fflori4n/smartHive/README.md

# smartHive
smart Hive sistem - ESP32 GSM base, that collects data from multiple atmell based field sensors and sends it via mqtt
