fflori4n/smartHive/ESP_field_sensor_hub/electronics/electronics_ESP_GSM_sens_hub/RSensHub.kicad_pcb

## KiCad design ESP_field_sensor_hub/electronics/electronics_ESP_GSM_sens_hub/RSensHub.kicad_pcb (2023-03-26)

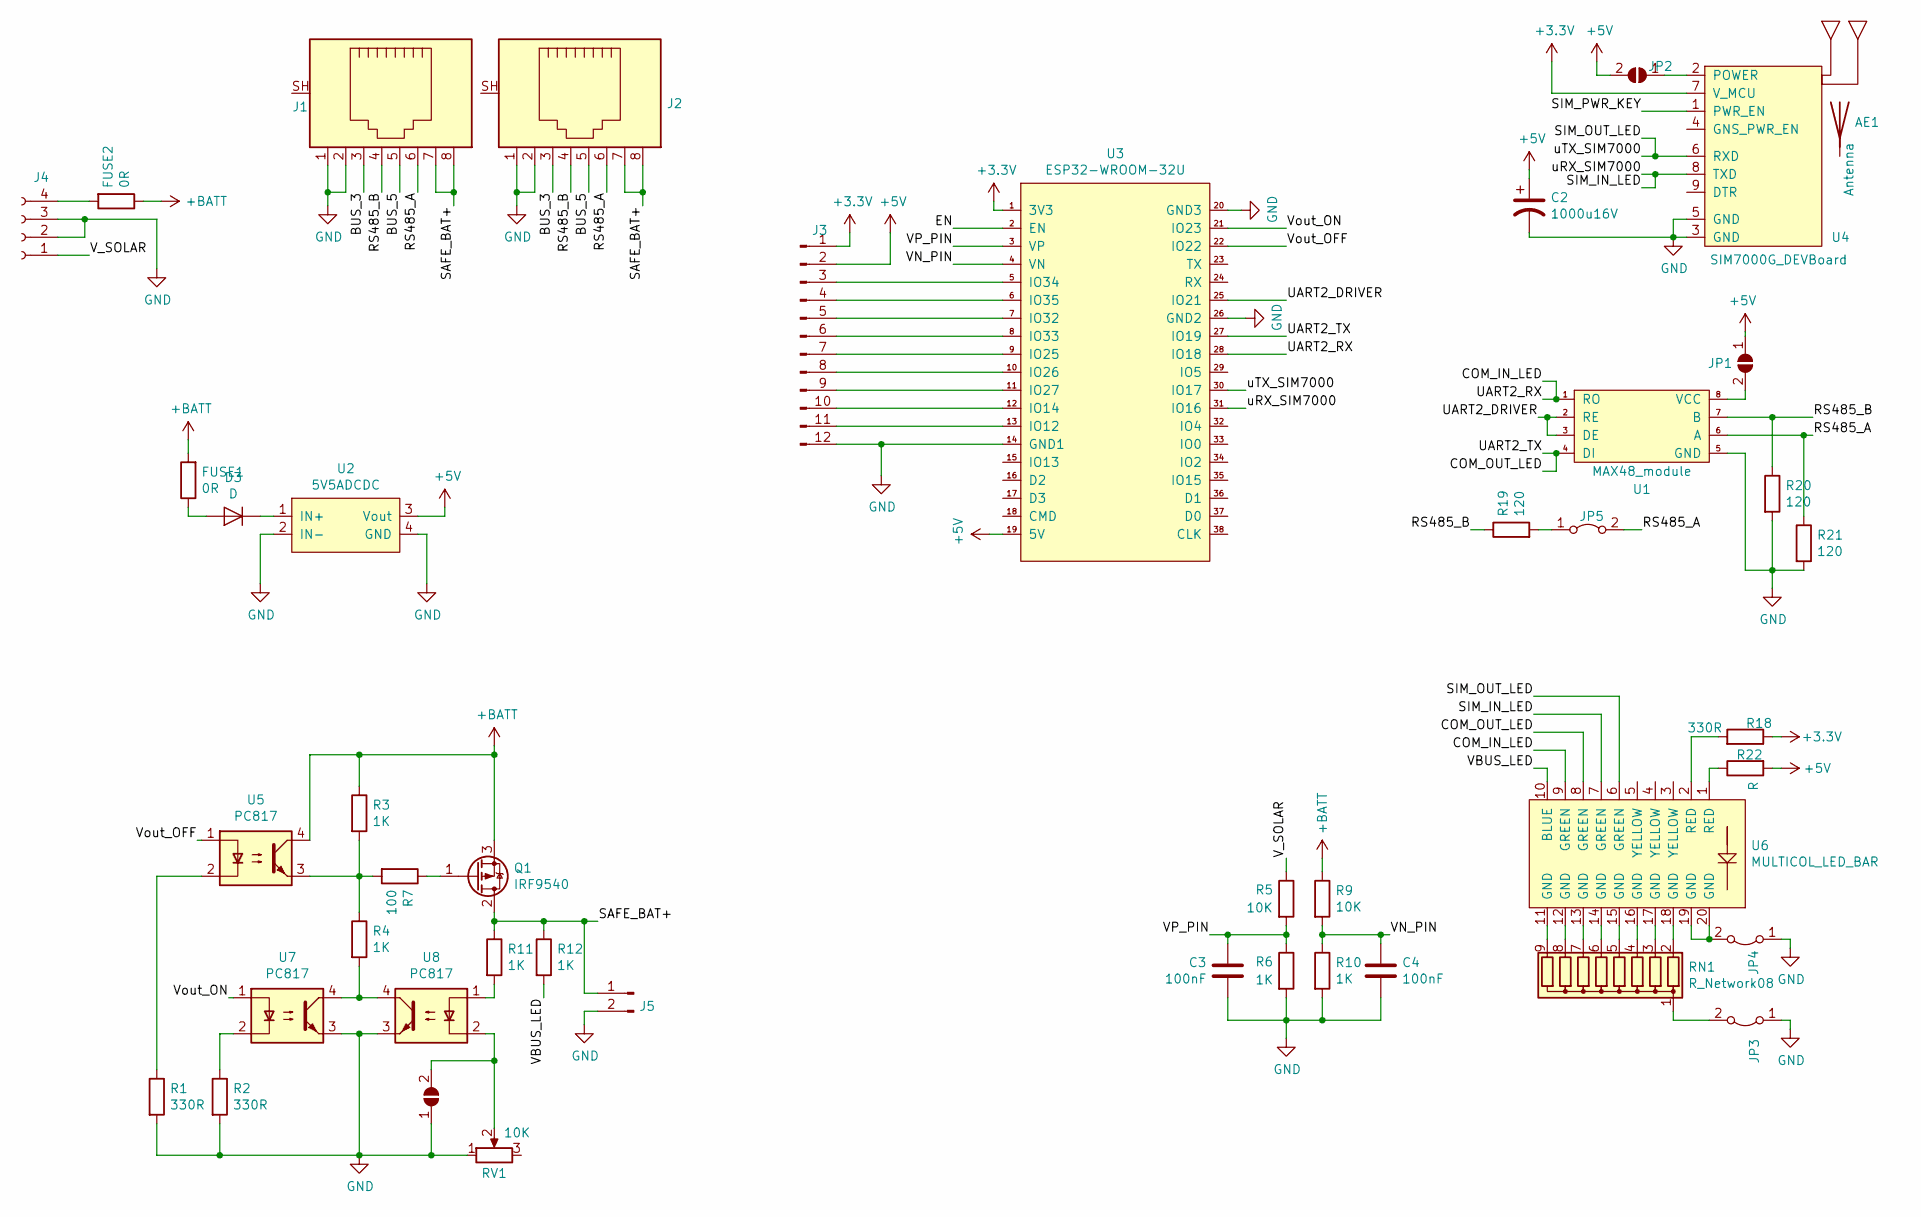
[picture p1: schematic RSensHub.sch]

Parts:
AE1: Antenna; GNSSantennaVertical
C2: 1000u16V; CAP_Radial_D10.0mm_P5.00mm
C3, C4: 100nF; Capker_L4.6mm_W2.0mm_P2.50mm
D3: D; 1N41_Diode
FUSE1, FUSE2: 0R; resistor0.25,9mm
J1, J2: RJ45_Shielded; RJ45
J3: Conn_01x12_Male; PinHeader_1x12_P2.54mm_widePads
J4: Conn_01x04_Female; TerminalBlockRemovablex4
J5: Conn_01x02_Male; TerminalBlockRemovablex2
JP1, JP2, JP6: SolderJumper_2_Open; SolderJumper-2_P1.3mm_Open_RoundedPad1.0x1.5mm
JP3, JP4: Jumper_2_Bridged; jumperx2_P2.54mm_widePads
JP5: RS485 terminator; jumperx2_P2.54mm_widePads
Q1: IRF9540; TO-220-3_Horizontal_TabDown_bothSides
R1, R2, R18: 330R; resistor0.25,9mm
R3, R4, R6, R10, R11, R12: 1K; resistor0.25,9mm
R5, R9: 10K; resistor0.25,9mm
R7: 100; resistor0.25,9mm
R19, R20, R21: 120; resistor0.25,9mm
R22: R; resistor0.25,9mm
RN1: R_Network08; PinHeader_1x9_P2.54mm_widePads
RV1: 10K; Potentiometer_ACP_CA9-V10_Vertical_Hole
U1: MAX48_module; MAX485_module
U2: 5V5ADCDC; DCDC_HCW_P715
U3: ESP32-WROOM-32U
U4: SIM7000G_DEVBoard; sim7000G_dev_board
U5, U7, U8: PC817; optoCouplerDIP4
U6: MULTICOL_LED_BAR; DIP-20_LED_BAR_DISP

Connections:
+3V3: J3.1, R18.1, U3.1 (3V3), U4.7 (V_MCU)
+5V: C2.1, J3.2, JP1.1 (A), JP2.2 (B), R22.2, U2.3 (Vout), U3.19 (5V)
+BATT: FUSE1.2, FUSE2.1, Q1.3 (S), R3.1, R9.1, U5.4; also elsewhere on the board
/BUS_3: J1.3, J2.3
/BUS_5: J1.5, J2.5
/COM_IN_LED: U1.1 (RO), U3.28 (IO18), U6.9 (GREEN)
/COM_OUT_LED: U1.4 (DI), U3.27 (IO19), U6.8 (GREEN)
/EN: U3.2 (EN)
/RS485_A: J1.6, J2.6, JP5.2 (B), R21.1, U1.6 (A)
/RS485_B: J1.4, J2.4, R19.1, R20.1, U1.7 (B)
/SAFE_BAT+: J1.7, J1.8, J2.7, J2.8, J5.1, Q1.2 (D), R11.1, R12.1
/SIM_IN_LED: U3.31 (IO16), U4.8 (TXD), U6.7 (GREEN)
/SIM_OUT_LED: U3.30 (IO17), U4.6 (RXD), U6.6 (GREEN)
/SIM_PWR_KEY: U4.1 (PWR_EN)
/UART2_DRIVER: U1.2 (RE), U1.3 (DE), U3.25 (IO21)
/VBUS_LED: R12.2, U6.10 (BLUE)
/VN_PIN: C4.1, R9.2, R10.1, U3.4 (VN)
/VP_PIN: C3.1, R5.2, R6.1, U3.3 (VP)
/V_SOLAR: J4.1, R5.1
/Vout_OFF: U3.22 (IO22), U5.1
/Vout_ON: U3.21 (IO23), U7.1
GND: C2.2, C3.2, C4.2, J1.1, J1.2, J2.1, J2.2, J3.12, J4.2, J4.3, J5.2, JP3.1 (A), JP4.1 (A), JP6.1 (A), R1.2, R2.2, R6.2, R10.2, R20.2, R21.2, RV1.1, U1.5 (GND), U2.2 (IN-), U2.4 (GND), U3.14 (GND1), U3.20 (GND3), U3.26 (GND2), U4.3 (GND), U4.5 (GND), U7.3, U8.3
unnamed: D3.1 (K), U2.1 (IN+)
unnamed 24: D3.2 (A), FUSE1.1; also elsewhere on the board
unnamed 25: FUSE2.2, J4.4; also elsewhere on the board
unnamed: J3.3, U3.5 (IO34)
unnamed: J3.4, U3.6 (IO35)
unnamed: J3.5, U3.7 (IO32)
unnamed: J3.6, U3.8 (IO33)
unnamed: J3.7, U3.9 (IO25)
unnamed: J3.8, U3.10 (IO26)
unnamed: J3.9, U3.11 (IO27)
unnamed: J3.10, U3.12 (IO14)
unnamed: J3.11, U3.13 (IO12)
unnamed: JP1.2 (B), U1.8 (VCC)
unnamed: JP2.1 (A), U4.2 (POWER)
unnamed: JP3.2 (B), RN1.1 (common)
unnamed: JP4.2 (B), U6.19 (GND), U6.20 (GND)
unnamed: JP5.1 (A), R19.2
unnamed: JP6.2 (B), RV1.2, U8.2
unnamed: Q1.1 (G), R7.1
unnamed: R1.1, U5.2
unnamed: R2.1, U7.2
unnamed: R3.2, R4.1, R7.2, U5.3
unnamed: R4.2, U7.4, U8.4
unnamed: R11.2, U8.1
unnamed: R18.2, U6.2 (RED)
unnamed: R22.1, U6.1 (RED)
unnamed: RN1.2 (R1), U6.18 (GND)
unnamed: RN1.3 (R2), U6.17 (GND)
unnamed: RN1.4 (R3), U6.16 (GND)
unnamed: RN1.5 (R4), U6.15 (GND)
unnamed: RN1.6 (R5), U6.14 (GND)
unnamed: RN1.7 (R6), U6.13 (GND)
unnamed: RN1.8 (R7), U6.12 (GND)
unnamed: RN1.9 (R8), U6.11 (GND)

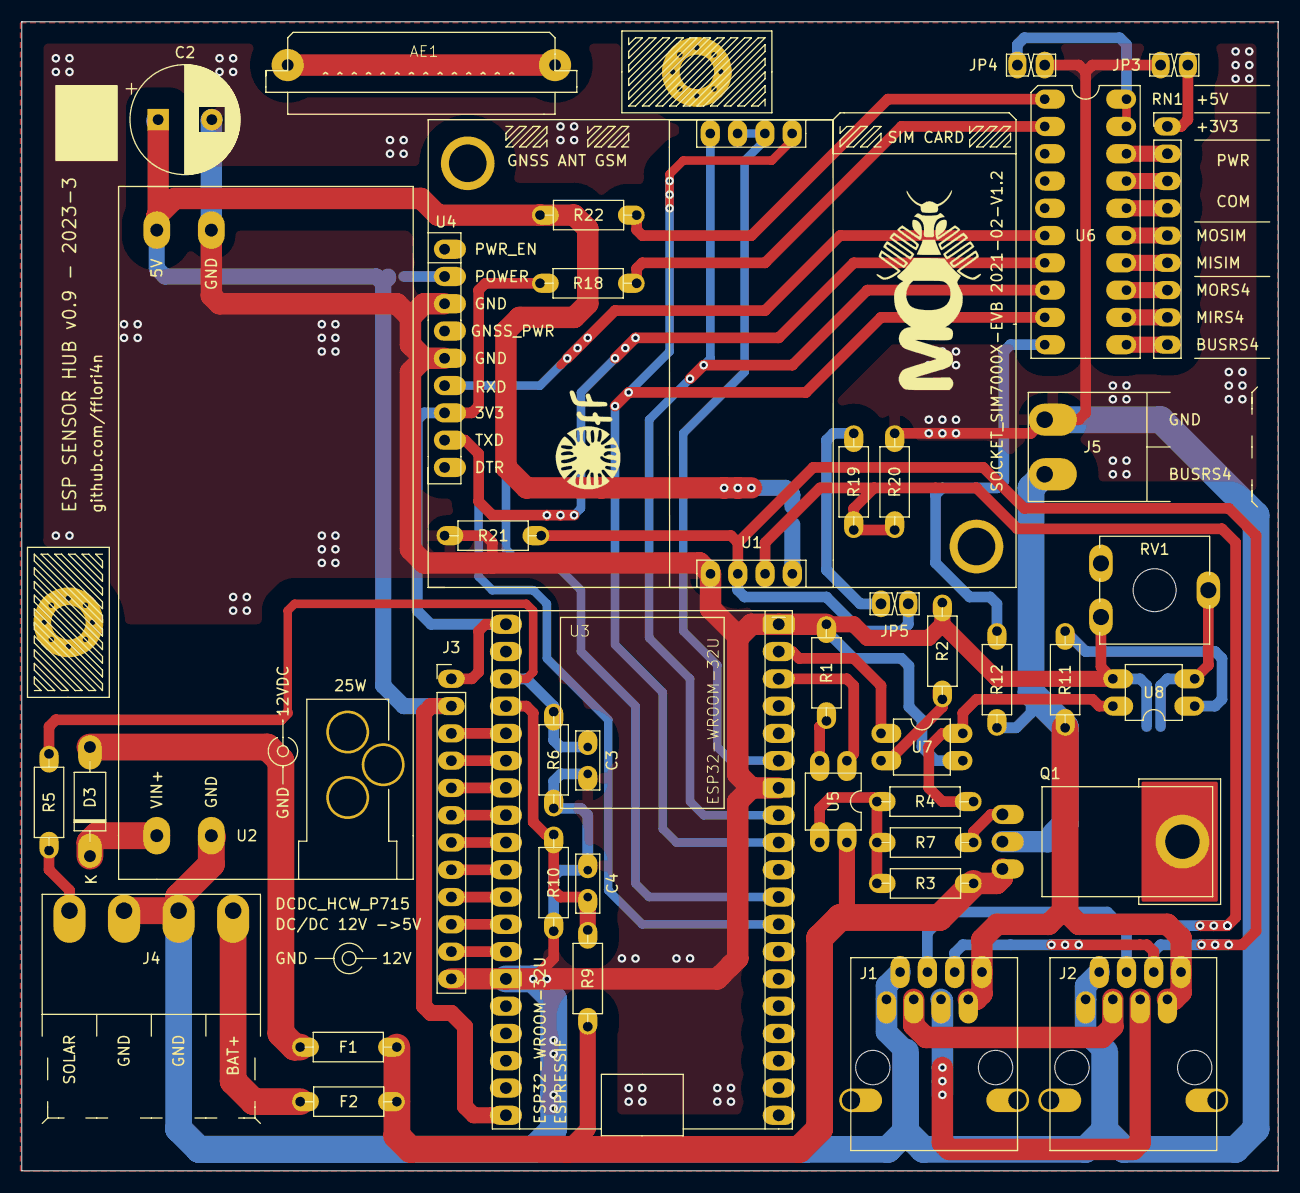
[picture p2: board RSensHub.kicad_pcb from above]

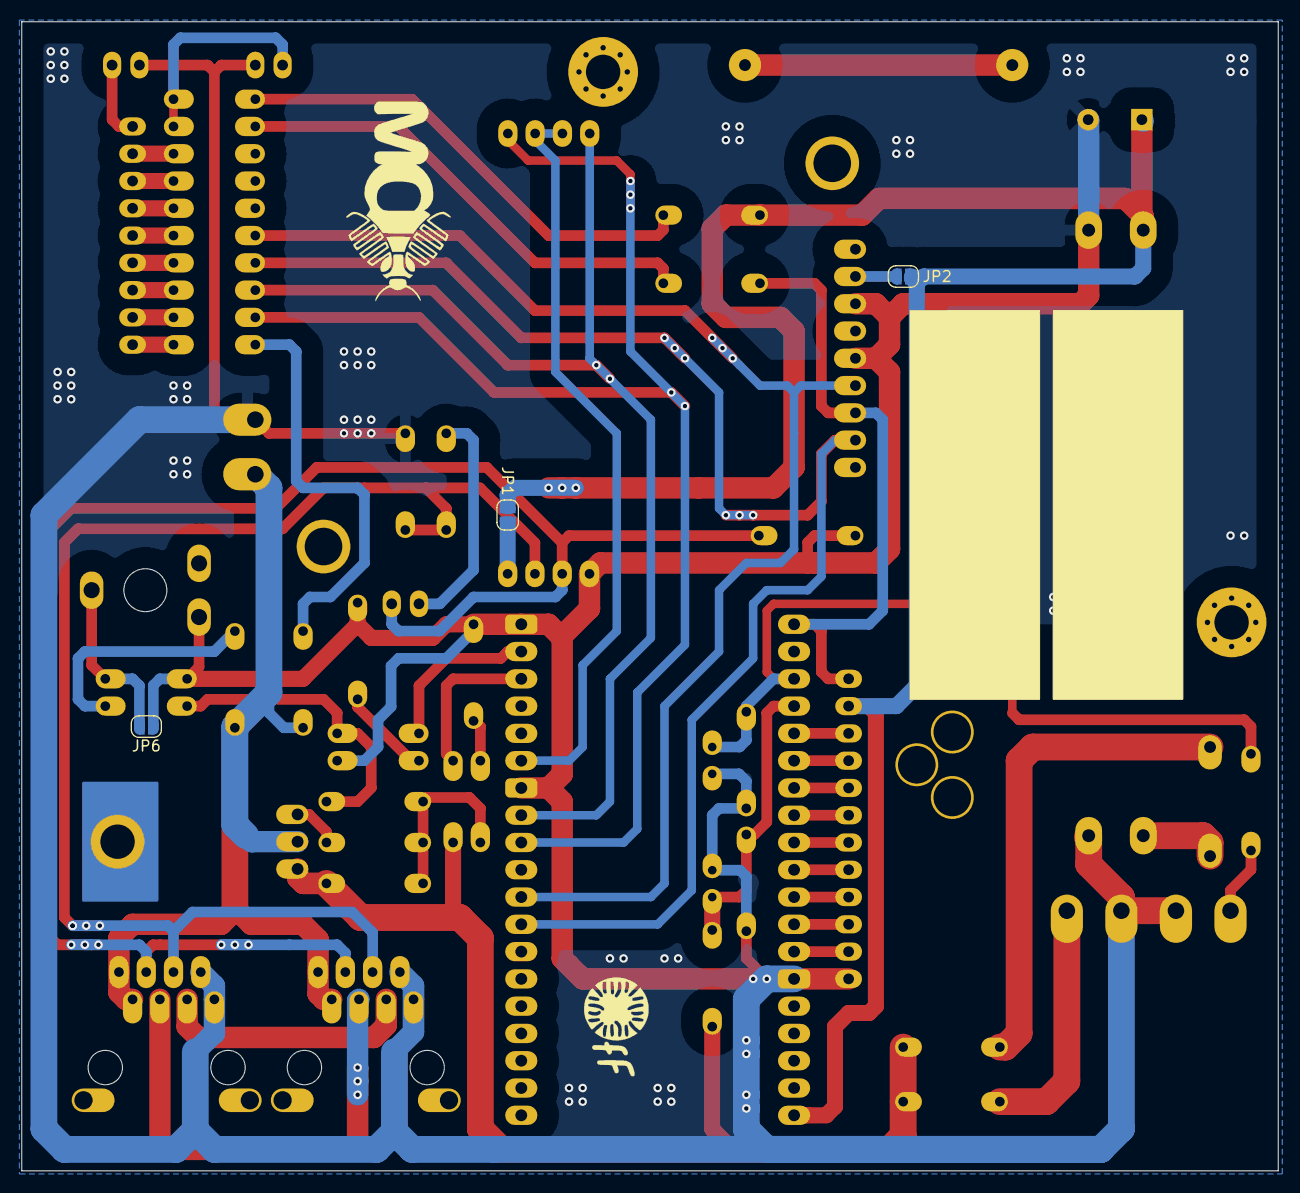
[picture p3: board RSensHub.kicad_pcb from below]

Board: 2 copper layers, 117.0 x 107.0 mm, 45 parts (3 on the bottom side), 54 nets.

Other parts of the board:
F1, F2: 0R; resistor0.25,9mm

Their connections:
+BATT: F1.2, F2.1; also elsewhere on the board
unnamed 24: F1.1; also elsewhere on the board
unnamed 25: F2.2; also elsewhere on the board
