fflori4n/smartHive/basic_hive_sensor/electronics/electronics_DHT_breakout/DHTBreakout.kicad_pcb

## KiCad design basic_hive_sensor/electronics/electronics_DHT_breakout/DHTBreakout.kicad_pcb (2022-12-19)

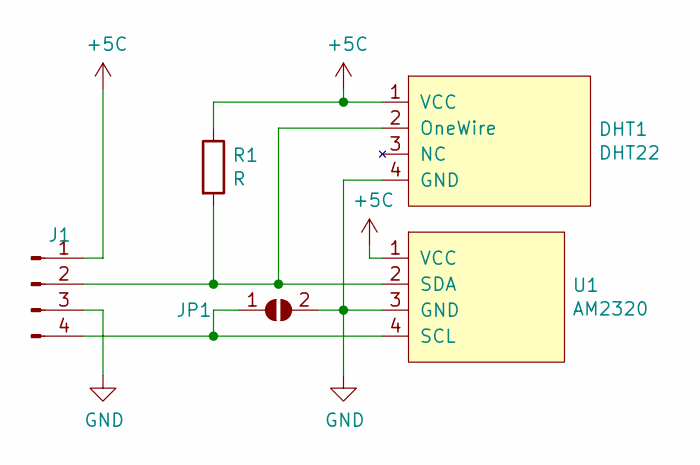
[picture p4: schematic DHTBreakout.sch]

Parts:
DHT1: DHT22; DHT_Horiz
J1: Conn_01x04_Male; DHT_4wireCable4mm
JP1: SolderJumper_2_Open; SolderJumper-2_P1.3mm_Open_Pad1.0x1.5mm
R1: R; resistor0.25,9mm
U1: AM2320; AM2320_Horiz

Connections:
+5C: DHT1.1 (VCC), J1.1, R1.1, U1.1 (VCC)
GND: DHT1.4 (GND), J1.3, JP1.2 (B), U1.3 (GND)
unnamed: DHT1.2 (OneWire), J1.2, R1.2, U1.2 (SDA)
unnamed: J1.4, JP1.1 (A), U1.4 (SCL)

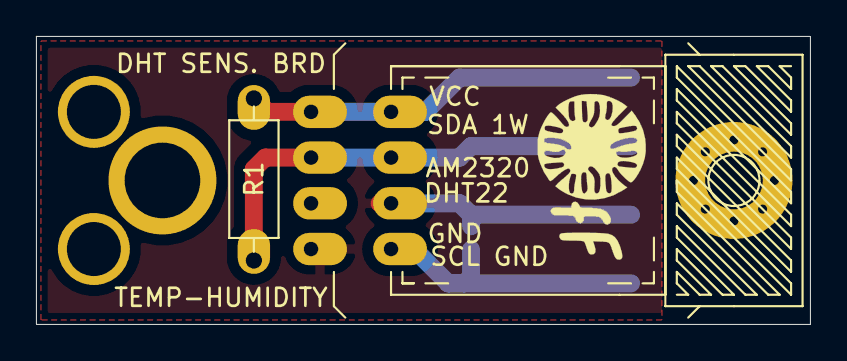
[picture p5: board DHTBreakout.kicad_pcb from above]

Board: 2 copper layers, 43.0 x 16.0 mm, 5 parts (1 on the bottom side), 4 nets.
