fflori4n/smartHive/basic_hive_sensor/electronics/electronics_basic_hive_sensor/basicHiveSensor.kicad_pcb

## KiCad design basic_hive_sensor/electronics/electronics_basic_hive_sensor/basicHiveSensor.kicad_pcb (2022-12-19)

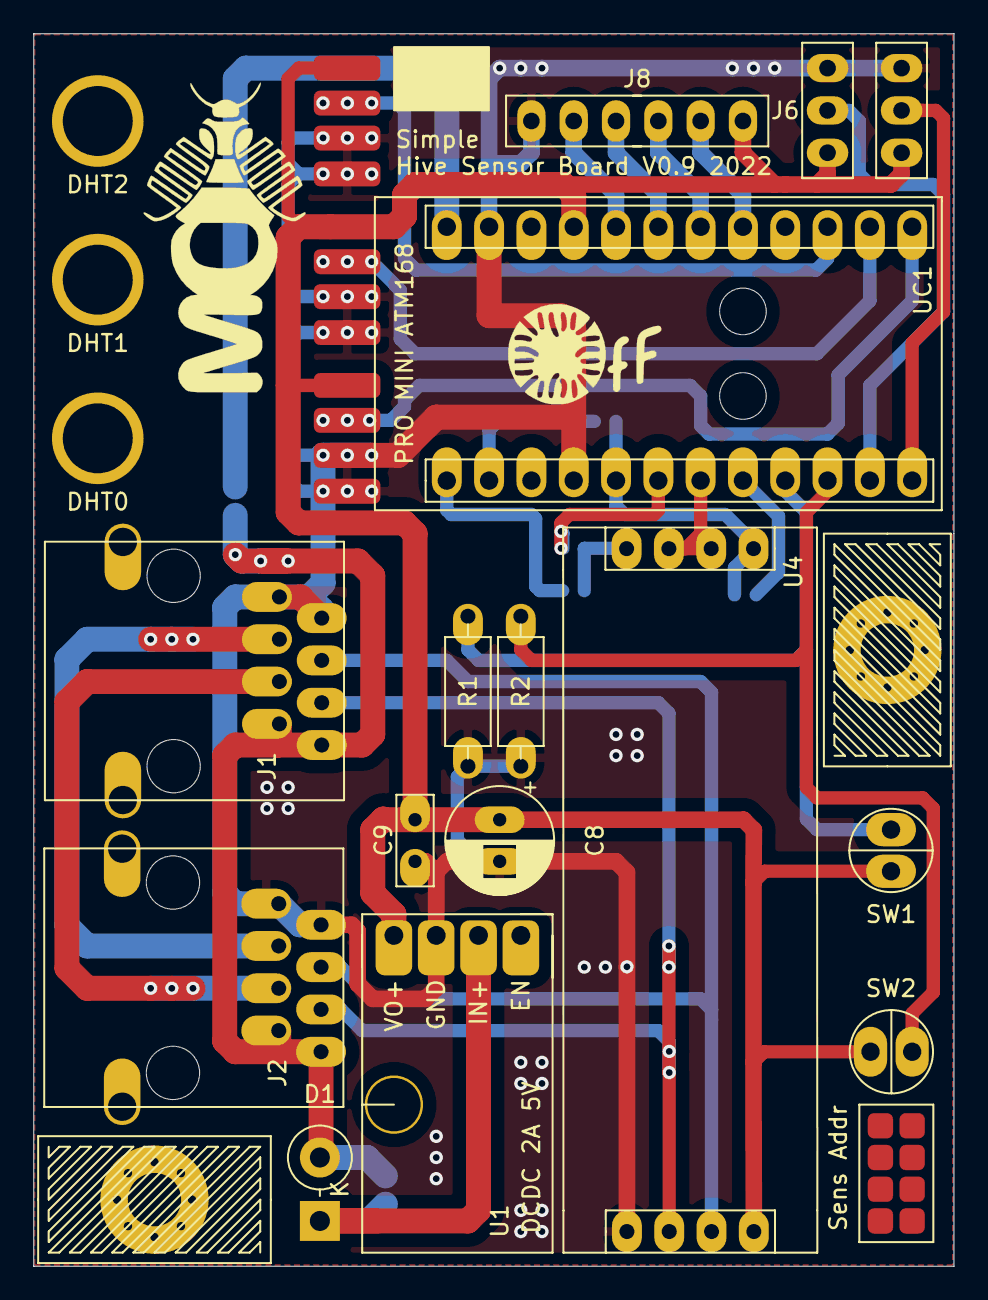
[picture p6: board basicHiveSensor.kicad_pcb from above]

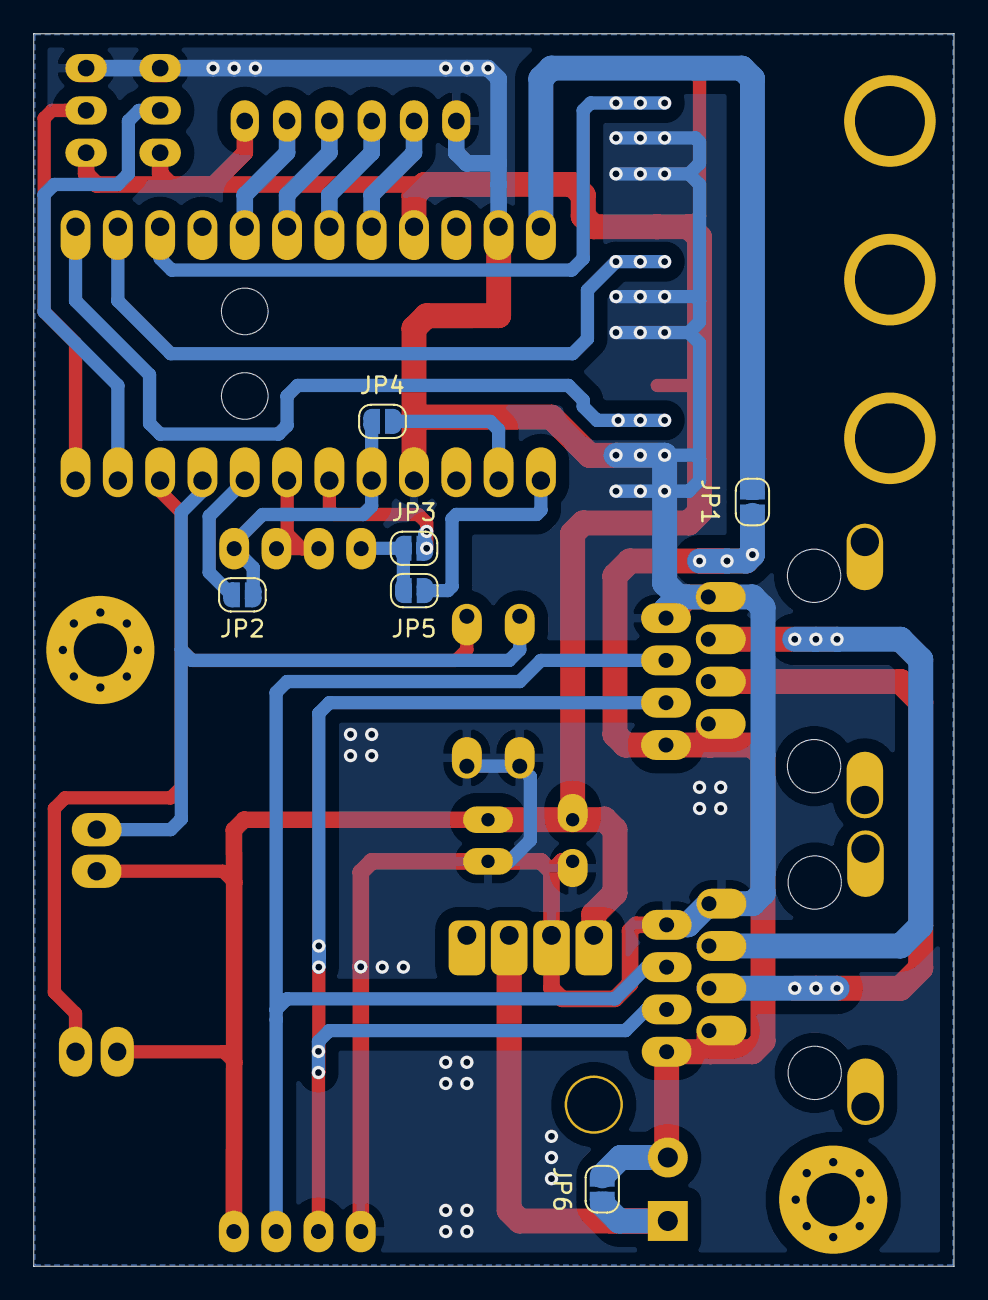
[picture p7: board basicHiveSensor.kicad_pcb from below]

Board: 2 copper layers, 55.2 x 74.0 mm, 24 parts (6 on the bottom side), 27 nets.

Parts:
C8: CP1; CAP_Radial_D6.3mm_P2.50mm100uF16V
C9: C; Capker_L4.6mm_W2.0mm_P2.50mm
D1: D_ALT; D_DO-15_P3.81mm_Vertical_KathodeUp
J1, J2: RJ45_Shielded; RJ45
J3, J4, J5: Conn_01x04_Male; Con_CopperPad1.5mmx4x4_withHole
J6, J7: Conn_01x03_Male; PinHeader_1x3_P2.54mm_widePads
J8: Conn_01x06_Male; PinHeader_1x6_P2.54mm_widePads
JP1, JP2, JP3, JP4, JP5, JP6: Sold; SolderJumper-2_P1.3mm_Open_RoundedPad1.0x1.5mm
R1, R2: R; resistor0.25,9mm
SW1, SW2: SW_Push_45deg; SW520-D5.2P2.5
U1: QSKJ_DCDC_1.8,2.5,3.3,5,9,12; Step Down 1.8V 2.5V 3.3V 5V 9V 12V (08-17V) 3A
U4: MAX48_module; MAX485_module
UC1: ProMiniClone; ProMiniCloneSocket_noAnalogPins

Connections:
+5V: C8.1, C9.1, J3.1, J4.1, J5.1, J6.1, J7.1, J8.1, SW1.2, SW2.2, U1.1, U4.8, UC1.9
+BATT: D1.2, J1.7, J1.8, J2.7, J2.8, JP1.1, JP6.2
/DHT0_DATA: J3.2, UC1.1
/DHT1_DATA: J4.2, UC1.2
/DHT2_DATA: J5.2, UC1.3
/GPIO0: R2.2, SW2.1, UC1.22
/GPIO1: R1.2, SW1.1, UC1.21
/GPIO2: J6.2, UC1.23
/GPIO3: J7.2, UC1.24
/GPIO4: J8.2, UC1.5
/GPIO5: J8.3, UC1.6
/GPIO6: J8.4, UC1.7
/GPIO7: J8.5, UC1.8
/MAX485_DE: U4.2, U4.3, UC1.19
/MAX485_DI: JP3.2, JP5.1, U4.4
/MAX485_RO: JP2.2, JP4.1, U4.1, UC1.17
/RS485_A: J1.6, J2.6, U4.6
/RS485_B: J1.4, J2.4, U4.7
/uRXD: JP4.2, UC1.14
/uTXD: JP5.2, UC1.13
GND: C8.2, C9.2, J1.1, J1.2, J2.1, J2.2, J3.3, J3.4, J4.3, J4.4, J5.3, J5.4, J6.3, J7.3, J8.6, R1.1, R2.1, U1.2, U4.5, UC1.11, UC1.16
unnamed: D1.1, JP6.1, U1.3
unnamed: J1.3, J2.3
unnamed: J1.5, J2.5
unnamed: JP1.2, UC1.12
unnamed: JP2.1, UC1.20
unnamed: JP3.1, UC1.18
