fflori4n/smartHive/ESP_field_sensor_hub/ESP32_gsm_sens_hub/SolarLogger.h

#define MAX_SOL_LOG_MESSAGE 30  /*C00147V12125L0001T 2535*/
#define SOL_LOG_DISABLED 1
#define SOL_LOG_DATA_BUFF_LEN 32

SoftwareSerial solarLogSerial(36, 33); /* Serial has to be inverted, because it is connected via inverting opto coupler, only RX is used*/

int16_t sol_voltage = -100;
int16_t sol_voltage_max;
int16_t sol_voltage_min;

int16_t sol_chargeCurrent = 21000;
int16_t sol_chargeCurrent_max;
int16_t sol_chargeCurrent_min;

int16_t sol_light = 10000;
float sol_batTemperature = -100.0;

char solLogData[SOL_LOG_DATA_BUFF_LEN];

void printCharArray(){
  for(int i=0; i < SOL_LOG_DATA_BUFF_LEN; i++){
    DebugSerial.print(solLogData[i]);
  }
}
int8_t updateSolLoggerData(){
   if(SOL_LOG_DISABLED){
    return 0;
   }
   if(!solarLogSerial.available()){
      return 0;
   }
   
   uint16_t numOfCharsRead = 0;
   uint16_t i=0; 
   for(i=0; i < SOL_LOG_DATA_BUFF_LEN; i++){
    solLogData[i] = '\0';
   }
   i=0;
   while (solarLogSerial.available() > 0 && numOfCharsRead < MAX_SOL_LOG_MESSAGE) {
    numOfCharsRead++;
    char inChar = solarLogSerial.read();
    /* @TODO: maybe check if chars are ascii alphanumeric*/
    if(i < SOL_LOG_DATA_BUFF_LEN){/*inChar != ' ' &&*/
      solLogData[i] = inChar;
      i++;
      DebugSerial.print(inChar);
    }
  }
 /* Serial.println(solLogData);*/
  if(numOfCharsRead >= MAX_SOL_LOG_MESSAGE){
    DebugSerial.println("SOLLOG | [ WR ] msg too long");
    for(int readChars=0; solarLogSerial.available() && (readChars <= 1000); readChars++){
      solarLogSerial.read();
    }
    return -1;
  }

  uint16_t reading = 0;
  for(int i=0; i < SOL_LOG_DATA_BUFF_LEN; i++){
    
    if(solLogData[i] == 'C' && (i + 5) < SOL_LOG_DATA_BUFF_LEN){
          bool alphanumeric = true;
          for(int j=1; j <= 5; j++){
            if((solLogData[i+j] - '0') > 9 || (solLogData[i+j] - '0') < 0){
              alphanumeric = false;
              break;
            }
          }
          if(alphanumeric){
            int16_t new_sol_chargeCurrent = ((solLogData[i+1] - '0') * 10000) + ((solLogData[i+2] - '0') * 1000) + ((solLogData[i+3] - '0') * 100) + ((solLogData[i+4] - '0') * 10) + ((solLogData[i+5] - '0') * 1);

            if(new_sol_chargeCurrent >= 0 && new_sol_chargeCurrent < 25000){
              if(sol_chargeCurrent == 21000){
                sol_chargeCurrent = new_sol_chargeCurrent;
              }
              else{
                /*sol_voltage_dev = (sol_voltage_dev * 0.99) + (0.1 * )*/
                sol_chargeCurrent = (int16_t)( (((float)sol_chargeCurrent) * 0.95) + (((float)new_sol_chargeCurrent) * 0.05) );
              }
            }
            DebugSerial.print("charge_current: ");
            DebugSerial.println(sol_chargeCurrent);
          }
    }

     if(solLogData[i] == 'V' && (i + 5) < SOL_LOG_DATA_BUFF_LEN){
          bool alphanumeric = true;
          for(int j=1; j <= 5; j++){
            if((solLogData[i+j] - '0') > 9 || (solLogData[i+j] - '0') < 0){
              alphanumeric = false;
              break;
            }
          }
          if(alphanumeric){
            int16_t new_sol_voltage =((solLogData[i+1] - '0') * 10000) + ((solLogData[i+2] - '0') * 1000) + ((solLogData[i+3] - '0') * 100) + ((solLogData[i+4] - '0') * 10) + ((solLogData[i+5] - '0') * 1);

            if(new_sol_voltage >= 5200 && new_sol_voltage < 40000){
              if(sol_voltage == -100){
                sol_voltage = new_sol_voltage;
              }
              else{
                /*sol_voltage_dev = (sol_voltage_dev * 0.99) + (0.1 * )*/
                sol_voltage = (int16_t)((((float)sol_voltage) * 0.98) + (((float)new_sol_voltage) * 0.02));
              }
            }
            DebugSerial.print("Voltage: ");
            DebugSerial.println(sol_voltage);
          }
    }

    if(solLogData[i] == 'L' && (i + 4) < SOL_LOG_DATA_BUFF_LEN){
          bool alphanumeric = true;
          for(int j=1; j <= 4; j++){
            if((solLogData[i+j] - '0') > 9 || (solLogData[i+j] - '0') < 0){
              alphanumeric = false;
              break;
            }
          }
          if(alphanumeric){
            sol_light =((solLogData[i+1] - '0') * 1000) + ((solLogData[i+2] - '0') * 100) + ((solLogData[i+3] - '0') * 10) + ((solLogData[i+4] - '0') * 1);
            DebugSerial.print("light: ");
            DebugSerial.println(sol_light);
          }
    }

    if(solLogData[i] == 'T' && (i + 5) < SOL_LOG_DATA_BUFF_LEN){
          bool alphanumeric = true;
          for(int j=1; j <= 5; j++){
            if( (solLogData[i+j] - ' ' != 0) && ((solLogData[i+j] - '0') > 9 || (solLogData[i+j] - '0') < 0)){
              alphanumeric = false;
              break;
            }
          }
          if(alphanumeric){
            sol_batTemperature =((solLogData[i+2] - '0') * 10) + ((solLogData[i+3] - '0') * 1) + ((solLogData[i+4] - '0') * 0.1 ) + ((solLogData[i+5] - '0') * 0.01);
            if(solLogData[i+1] - '-' == 0){
              sol_batTemperature *= -1.0;
            }
            DebugSerial.print("bat_temp: ");
            DebugSerial.println(sol_batTemperature);
          }
    }
  }

  if(sol_voltage > sol_voltage_max){
    sol_voltage_max = sol_voltage;
  }
  if(sol_voltage < sol_voltage_min){
    sol_voltage_min = sol_voltage;
  }

  if(sol_chargeCurrent > sol_chargeCurrent_max){
    sol_chargeCurrent_max = sol_chargeCurrent;
  }
  if(sol_chargeCurrent < sol_chargeCurrent_min){
    sol_chargeCurrent_min = sol_chargeCurrent;
  }
}

void addSolLoggerMqttTags(char(& mqttPayloadBuff)[MQTT_PAYLOAD_BUFF_LEN], char(& tempStrBuffer)[_TEMP_STRLEN]){
  if(sol_voltage > 0 && sol_voltage < 99000){
    snprintf(tempStrBuffer, _TEMP_STRLEN, " \"v_sol\":%d.%d,",(int)(sol_voltage/1000), (((int)sol_voltage)%1000)/10);
    strcat(mqttPayloadBuff, tempStrBuffer);
  }
  /**else{
    snprintf(tempStrBuffer, _TEMP_STRLEN, " \"v_sol\":None,");
    strcat(mqttPayloadBuff, tempStrBuffer);
  }*/
  /*if(sol_voltage_max > 0 && sol_voltage_max < 99000){
    snprintf(tempStrBuffer, _TEMP_STRLEN, " \"v_solM\":%d.%d,",(int)(sol_voltage_max/1000), (((int)sol_voltage_max)%1000)/10);
    strcat(mqttPayloadBuff, tempStrBuffer);
  }
  if(sol_voltage_min > 0 && sol_voltage_min < 99000){
    snprintf(tempStrBuffer, _TEMP_STRLEN, " \"v_solm\":%d.%d,",(int)(sol_voltage_min/1000), (((int)sol_voltage_min)%1000)/10);
    strcat(mqttPayloadBuff, tempStrBuffer);
  }*/
  
  if(sol_chargeCurrent >-1 && sol_chargeCurrent < 20000){
    snprintf(tempStrBuffer, _TEMP_STRLEN, " \"sol_charge_i\":%d,",(int)(sol_chargeCurrent));
    strcat(mqttPayloadBuff, tempStrBuffer);
  }
  /*else{
    snprintf(tempStrBuffer, _TEMP_STRLEN, " \"sol_charge_i\":None,");
    strcat(mqttPayloadBuff, tempStrBuffer);
  }*/
 /* if(sol_chargeCurrent_min >-1 && sol_chargeCurrent_min < 20000){
    snprintf(tempStrBuffer, _TEMP_STRLEN, " \"sol_charge_im\":%d,",(int)(sol_chargeCurrent_min));
    strcat(mqttPayloadBuff, tempStrBuffer);
  }
  if(sol_chargeCurrent_max >-1 && sol_chargeCurrent_max < 20000){
    snprintf(tempStrBuffer, _TEMP_STRLEN, " \"sol_charge_iM\":%d,",(int)(sol_chargeCurrent_max));
    strcat(mqttPayloadBuff, tempStrBuffer);
  }*/
  
  if(sol_light >-1 && sol_light < 9999){
    snprintf(tempStrBuffer, _TEMP_STRLEN, " \"sol_light\":%d,",(int)(sol_light));
    strcat(mqttPayloadBuff, tempStrBuffer);
  }
  /*else{
    snprintf(tempStrBuffer, _TEMP_STRLEN, " \"sol_light\":None,");
    strcat(mqttPayloadBuff, tempStrBuffer);
  }
  */
  /*if(sol_batTemperature >-99 && sol_chargeCurrent < 99){
    snprintf(tempStrBuffer, _TEMP_STRLEN, " \"sol_bat_temp\":%d.%d,",(int)(sol_batTemperature),(int)(abs(sol_batTemperature)*10)%100);
    strcat(mqttPayloadBuff, tempStrBuffer);
  }*/
  /*else{
    snprintf(tempStrBuffer, _TEMP_STRLEN, " \"sol_bat_temp\":None,");
    strcat(mqttPayloadBuff, tempStrBuffer);
  }*/
  sol_voltage = -100;
  sol_chargeCurrent = 21000;
  sol_batTemperature = -100;
  sol_light = 10000;
}
