fflori4n/smartHive/RS485_Nano_testTool/RS485DBGtool/RS485DBGtool.ino

#include <SoftwareSerial.h>
//#include <SerialTransfer.h>
#include "DHT.h"

#include "dht.h"
#include "RS485Com.h"

#define RO_PIN 10
#define DI_PIN 11
#define DE_PIN 12



//DHTSensor dht1(9, DHT22);

double dht0Temp = -99;
double dht0Hum = -99;

SoftwareSerial Serial485 (RO_PIN, DI_PIN); // RX, TX

class RS485COM {

#define BAUD 9600
#define MASTER_ADDR '0'
#define MY_ADDR '0'
#define START_BYTE "<<<"
#define STOP_BYTE ">>>"
#define IN_BUF_SIZE 32

#define POLL_ALL "POL*"

#define CRC_ENABLED 1
#define PRINT2_DBG_SER
#define VERB_SER 1


  private:
  public:

    RS485COM() {
      Serial485.begin(BAUD);
      pinMode(DE_PIN, OUTPUT);
      digitalWrite(DE_PIN, LOW); /// Driver disabled - listening only
    }

    /*int sendPollFrame(){
      AF,POL*
    }*/
    int sendMsg(char (& payloadMsg)[190]) {
      uint16_t crc = crc16(payloadMsg, strlen(payloadMsg));
      uint16_t payloadLen = strlen(payloadMsg);
      
      char crcHighP = ((char*) &crc)[1];
      char crcLowP = ((char*) &crc)[0];

      char crcHigh = (crc >> 8);
      char crcLow = (crc & 0xFF);

    

      Serial.print("pointer CRC:");
      Serial.print((uint8_t)crcHighP);
      Serial.print(" ");
      Serial.println((uint8_t)crcLowP);

      Serial.print("bitwise CRC:");
      Serial.print((uint8_t)crcHigh);
      Serial.print(" ");
      Serial.println((uint8_t)crcLow);
      
      /*String inStr = payloadMsg;
      inStr += ((char*) &crc)[1];
      inStr += ((char*) &crc)[0];
      inStr = START_BYTE + inStr + STOP_BYTE;*/

      /*payloadMsg[payloadLen+5] = '\0';
      payloadMsg[payloadLen+4] = '>';
      payloadMsg[payloadLen+3] = '>';
      payloadMsg[payloadLen+2] = '>';
      payloadMsg[payloadLen+1] = crcHigh;//crc1;//crc1;//(char)(crc | 0xFF);
      payloadMsg[payloadLen] = crcLow;//crc0;//(char)(crc >> 8);
      //shiftBuffRight(payloadMsg,3, '<');*/

      digitalWrite(13, HIGH);
      digitalWrite(DE_PIN, HIGH); /// Driver enabled - send
      delayMicroseconds(5000);
      Serial485.print("<<<");
      Serial485.print(payloadMsg);
      Serial485.print(crcHigh);
      Serial485.print(crcLow);
      Serial485.print(">>>");
      Serial.println(payloadMsg);
      delayMicroseconds(5000);
      digitalWrite(DE_PIN, LOW); /// Driver disabled - listening only
      delay(100);
      digitalWrite(13, LOW);


#ifdef VERB_SER
      Serial.print("sent: ");
     // Serial.println(inStr);
#endif

    }
    int sendStr(char (& payloadMsg)[190]) {
      uint16_t crc = crc16(payloadMsg, strlen(payloadMsg));
      String inStr = payloadMsg;
      inStr += ((char*) &crc)[1];
      inStr += ((char*) &crc)[0];
      inStr = START_BYTE + inStr + STOP_BYTE;

      Serial.print("Second CRC:");
      Serial.print((uint8_t)((char*) &crc)[1]);
      Serial.print(" ");
      Serial.println((uint8_t)((char*) &crc)[0]);

      digitalWrite(13, HIGH);
      digitalWrite(DE_PIN, HIGH); /// Driver enabled - send
      delayMicroseconds(5000);
      Serial485.print(inStr);
      delayMicroseconds(5000);
      digitalWrite(DE_PIN, LOW); /// Driver disabled - listening only
      delay(100);
      digitalWrite(13, LOW);


#ifdef VERB_SER
      Serial.print("sent: ");
     // Serial.println(inStr);
#endif

    }

    
    char msgBuff[200] = "";
    /*void createPollFrame(){ /// used by master only.
      snprintf(msgBuff, MSGBUFF_LEN, "AF,POL*");
      uint8_t msgPayloadLen = strlen(msgBuff);//strlen(msgBuff);
     // uint16_t crc = crc16("AF,POL*", strlen("AF,POL*"));//
      String inStr = "AF,POL*";
      uint16_t crc = crc16(msgBuff, msgPayloadLen);
      

      uint8_t crc0 = ((char*) &crc)[1];
      uint8_t crc1 = ((char*) &crc)[0];

      /*Serial485.print("<<<");
      Serial485.print("AF,POL*");
      Serial485.print(crc0);
      Serial485.print(crc1);
      Serial485.print(">>>");
      return;
      Serial.println();
      Serial.print(crc0);
      Serial.print(" ");
      Serial.print(crc1);
      Serial.println();

      msgBuff[msgPayloadLen+5] = '\0';
      msgBuff[msgPayloadLen+4] = '>';
      msgBuff[msgPayloadLen+3] = '>';
      msgBuff[msgPayloadLen+2] = '>';
      msgBuff[msgPayloadLen+1] = crc0;//(char)(crc | 0xFF);
      msgBuff[msgPayloadLen] = crc1;//(char)(crc >> 8);
      Serial.print("Second CRC:");
      Serial.print((uint8_t)(msgBuff[msgPayloadLen+1]));
      Serial.print(" ");
      Serial.println((uint8_t)(msgBuff[msgPayloadLen]));
     // shiftBuffRight(3, '<');

      printBuff();
      //sendBuffStr();

      digitalWrite(13, HIGH);
      digitalWrite(DE_PIN, HIGH); /// Driver enabled - send
      delayMicroseconds(5000);
      Serial485.print("<<<");
      for(int i=0; i<strlen(msgBuff); i++){
        Serial485.print(msgBuff[i]);
        Serial.print(msgBuff[i]);
      }
      delayMicroseconds(5000);
      digitalWrite(DE_PIN, LOW); /// Driver disabled - listening only
      delay(100);
      digitalWrite(13, LOW);

    }*/
    /* void shiftBuffRight(uint8_t &len,byte places, char shiftIn){  /// rightmost bit will be lost, but I don't care
      for(; places > 0; places--){
        for(int i= (len - 2); i>=0; i--){
        msgBuff[i+1] = msgBuff[i];
        }
        msgBuff[0] = shiftIn;
      }
    }*/
    void printBuff(uint8_t &len){
      for(int i=0; i<len; i++){
        Serial.print(msgBuff[i]);
      }
    }
    /*int parseIncoming(String &rawStr) {

#ifdef VERB_SER
      Serial.println(rawStr);
      Serial.println(rawStr[0]);
#endif

      if (rawStr[0] != MY_ADDR) {
        Serial.print(F("MSG not for me"));
        Serial.println(rawStr[1]);
        return -1;
      }
#ifdef CRC_ENABLED
      if (crc16(rawStr.c_str(), rawStr.length()) != 0) { /// CRC check, zero validation
        Serial.println("[ER] wrong CRC");
        return -1;
      }
#endif

      Serial.println("[OK] got:");

      /// Drop the CRC and the to Addr
      rawStr = rawStr.substring(rawStr.lastIndexOf(","), rawStr.length() - 2);
      Serial.println(rawStr);
      this->respPollAll();
    }*/
    
    int checkIncoming() {   /// 0 - polled, -1 - error, 1 - nothing
      /// <2,POL*>


      bool msgStarted = false;
      bool rdyToParse = false;
      String inStr = "";

      while (Serial485.available()) {
        char inChar = Serial485.read();
        Serial.print(inChar);
       /* if (inChar == START_BYTE) {
          msgStarted = true;
        }
        else if (inChar == STOP_BYTE) {
          rdyToParse = true;
          break;
        }
        else if (msgStarted) {
          if (inStr.length() >= IN_BUF_SIZE) {
            Serial.println(F("[ER] incoming MSG too long."));
            return -1;
          }
          else {
            inStr.concat(inChar);
          }
        }*/
      }
     /* if (!msgStarted) {
        return 0;
      }
      if (!rdyToParse && msgStarted) {
        Serial.println(F("[ER] incomplete MSG"));
        return -1;
      }
      this->parseIncoming(inStr);*/
      
#ifdef UART_CMDS_ENABLED
      while (Serial.available()) {
        char inChar = Serial.read();

        if (inChar == START_BYTE) {
          msgStarted = true;
        }
        else if (inChar == STOP_BYTE) {
          rdyToParse = true;
          break;
        }
        else if (msgStarted) {
          if (inStr.length() >= IN_BUF_SIZE) {
            Serial.println(F("[ER] incoming MSG too long."));
            return -1;
          }
          else {
            inStr.concat(inChar);
          }
        }
      }
      if (!msgStarted) {
        return 0;
      }
      if (!rdyToParse && msgStarted) {
        Serial.println(F("[ER] incomplete MSG"));
        return -1;
      }
      this->parseIncoming(inStr);
#endif;
      return 0;
    }


    /// from: https://stackoverflow.com/questions/17196743/crc-ccitt-implementation sarvankumar_t
    /// crc16 implementation that works with zero verification CRC-CCITT in XMODEM
    unsigned short crc16(char *ptr, int count) {
      int  crc = 0;
      char i;
      //crc = 0;
      while (--count >= 0) {
        crc = crc ^ (int) * ptr++ << 8;
        i = 8;
        do
        {
          if (crc & 0x8000)
            crc = crc << 1 ^ 0x1021;
          else
            crc = crc << 1;
        } while (--i);
      }
      return crc;
    }

    /*void respPollAll() {
      String proba = "0,2,A,20.20,80.30,40.20,60.2,50.2,30.28";
      this->sendStr(proba);
    }*/
};


RS485COM serCom;
RS485Com rsSerial;
void setup() {
  Serial.begin(9600);

  pinMode(13, OUTPUT);
  Serial485.begin(BAUD);
  pinMode(DE_PIN, OUTPUT);
  digitalWrite(DE_PIN, LOW); /// Driver disabled - listening only

  //serCom.sendQuerry(2);
  //Serial.println("first:");
  //char msg[190] = "AF,POL*";
  //char* msg = "POL*";
  //serCom.sendStr(msg);
  //Serial.println("second:");
  //serCom.sendMsg(msg);
  //char a = 'A';
  //rsSerial.sendMsg(a, msg);
  //serCom.createPollFrame();
  //msg = "2,POL*";
  //rsSerial.pollSensor((char)65,(char)70);
  //serCom.sendStr(msg);

}
void loop() {

  /* serCom.send("hello world!", 0,1);
    delay(500);*/
  rsSerial.pollSensor((char)65,(char)70);
  delay(2000);
  serCom.checkIncoming();
  delay(5000);
  rsSerial.pollSensor((char)66,(char)70);
  delay(2000);
  serCom.checkIncoming();
  delay(5000);

  delay(1000);
  //dht1.read();
  //dht1.dbgPrint();

}
