fflori4n/smartHive/(commit log)

2022-12-19 initial commit.
    [DHTBreakout.kicad_pcb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]
2022-12-22 reading voltage and adding to mqtt message ( very cursed but works ), voltage measurement is incorrect, TODO: fix it
    [ESP32_gsm_sens_hub.ino, Mqtt.h, ReadVoltage.h]
2022-12-30 Crated footprints for GSM board and Antenna and changed up status LEDs
2022-12-30 TODO: Found huge bug, needs fixing - if crc bit is '\0' whole cstring system breaks Sender will not send string, reciever will not parse string.
    commented out all sim functionality for now, rework and optimise whole RS485Com.h before doing anything else.
    pins 18,19,21 work OK on the ESP for the RS485 uart, connect them on the schematic
    [ESP32_gsm_sens_hub.ino, RS485Com.h]
2023-01-03 Fixed '\0' issue probably... but addresess should still be alphanumeric Unified sending and encoding function
    [RS485Com.h, RS485DBGtool.ino, basic_hive_sensor.ino]
2023-01-04 Got two sensors to work, communication and addressing is OK so far. AM2320 is the same sensor as DHT22 so the standard DHT.h library can deal with it fine
2023-01-05 worked on basic hive
    added method for getting DHT sensor data, checking if data is valid and averageing sensor values
    changed - rearanged interrupt and sleep functions
    changed - DHT sensor reading is done triggered by timer interrupt
    added PIR or microwave motion detector support - works with polling, but should really be interrupt. - pinchange interrupt conflicts with software serial - does it worth migrating to new soft serial library?
    added warning light when module did not get poll from master for some time
2023-01-07 Working on ESP sensor class
2023-01-07 wrote BasicHiveSensor.h, can define sensors, can set address timeout for sensors, has functions for polling and parsing sensor data - parsing is not working, gona change the format to be easily parse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
    [BasicHiveSensor.h, ESP32_gsm_sens_hub.ino, RS485Com.h, basic_hive_sensor.ino]
2023-01-07 damn C. had to write parser to convert string to double, still not working for last two tags :(
    [BasicHiveSensor.h]
2023-01-08 fixed CSV parsing with dirty fix, needs more work. Added mqtt string creation to basicHive class - TODO: strlcat instead of strcat everywhere to avoid buff overflow & separate mqtt payload string cre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
    [BasicHiveSensor.h, ESP32_gsm_sens_hub.ino, Mqtt.h]
2023-01-08 mqtt working for both types - Sofware serial does not for some reason work for RS485 and SIM uarts at the same time, using HWserial for sim now. Heavy cleanup needed.
2023-01-09 Basic hive sensor - made the DHT reading more reliable, added internal pullups for data lines. PIR sensor is now polled in ISR, working. added ifdef-s for unused DHT sensors
2023-01-10 worked on sens hub PCB
    [RSensHub.kicad_pcb, RSensHub.sch]
2023-02-03 short circuit protection - tested on dot board, ESP control pins not connected
    [RSensHub.kicad_pcb, RSensHub.sch, bGate.kicad_pcb, bGate.sch]
2023-02-04 GPIO 22 and 23 set turn the sensor bus power on or off
2023-02-04 worked on sens hub PCB layout, mostly done, needs finishing touches
    [RSensHub.kicad_pcb, RSensHub.sch]
2023-02-05 routed and copper poutred PCB for ESP sensor hub TODO: labels and PCB logos
    [RSensHub.kicad_pcb]
2023-03-26 started working on GNSS time and NTP functionality, ESP32 timekeeping works, just need to update it from modem. need to parse the GNSS status for string. Played around with chatGPT, and got a fairly 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
    [RSensHub.kicad_pcb, RSensHub.sch, basicHiveSensor.sch]
2023-03-27 Refactoring SIM7000, writing function for not spaghetti parsing of GNSS CSV string @TODO: not finished
    [RSensHub-B_Cu.gbl, RSensHub-B_Mask.gbs, RSensHub-B_Paste.gbp, RSensHub-B_SilkS.gbo, RSensHub-Edge_Cuts.gm1, RSensHub-F_Cu.gtl, RSensHub-F_Mask.gts, RSensHub-F_Paste.gtp]
2023-04-02 Added sensor response tracking to detect is sensor is offline, added multiple poll request sending when sensor does not respond. Fixed voltage double to mqtt string conversion bug. @TODO: JSON parsin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
    [BasicHiveSensor.h, ESP32_gsm_sens_hub.ino, ReadVoltage.h, basic_hive_sensor.ino, sim7000.h]
2023-04-05 added timed sensor reading and mqtt sending, mqtt msg should arrive every 5 minutes at 0 or 5 min mark.
2023-04-29 trying to fix, wrong value read when power is interrupted, optimised code, com is now priority, sensor will wait a few seconds before reading sensors when power is turned on. Moved all config macros 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
    [RS485Com.h, basic_hive_sensor.ino, setup.h]
2023-04-30 bugfix of temp/humidity errors( hopefully ), 2 secs should pass between dht sensor polls, DHT library has inbuilt waiting period, and if read.temperature() and read.humidity() are called one after th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
    [BasicHiveSensor.h, ESP32_gsm_sens_hub.ino, basic_hive_sensor.ino, setup.h]
2023-05-06 added second mode of internet connectivity, modem can now use both Wi-Fi using PubSubClient library, and GSM, one is primary, other is backup device. Replaced 10K pull-up resistors with 4K7 on one wi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
    [ESP32_gsm_sens_hub.ino, Mqtt.h, wifiFunctions.h]
2023-08-05 made prototype MCU for logging solar charge current, voltage and bat temp, connected it to Gateway using bitbanged UART, but only one direction, added mqtt tags
2023-08-19 removed solar logger and integrated sensors into main rtu, removed current sensor because it's measurements were erratic, probably max current rating is too low for this application, and sensor got f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
    [ESP32_gsm_sens_hub.ino, ReadVoltage.h]
2023-11-25 added watchdog timer and sending reboot reason and memory debug info to server, sim7000 firmware can sometimes freeze and need a power cycle to come online - mayor headace but mostly does not happen,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
    [BasicHiveSensor.h, ESP32_gsm_sens_hub.ino, ESPtime.h, Mqtt.h, ReadVoltage.h, basic_hive_sensor.ino, sensHubInfo.h]
2023-12-09 fixed negative temp bug, added periodic reset of SIM7000 and PSM power saving mode
    [ESP32_gsm_sens_hub.ino, ReadVoltage.h, SolarLogger.h]
2023-12-26 added external power cutoff for low battery, corrected error handling of SIM AT commands, todo: still more work to be done here.
    [betCutoff.kicad_pcb, betCutoff.kicad_sch]
2024-06-15 SIM class rework to clean up and add functions for common actions, and fixed parsing of responses since I'm a professional now and had to make it less shit
    [ESP32_gsm_sens_hub.ino, ESPtime.h, Mqtt.h, ReadVoltage.h, sensHubInfo.h, sim7000.h]
2024-07-02 fixed annoying software serial incompatibility, now using 3 Hardware UARTs on ESP and SW on ATM168
    [BasicHiveSensor.h, ESP32_gsm_sens_hub.ino, ESPtime.h, Mqtt.h, RS485Com.h, ReadVoltage.h, SolarLogger.h, basic_hive_sensor.ino]
